Soap-hub-AA/stm32-thermo-clock/hardware/SCH_Schematic1_2026-10-10.pdf

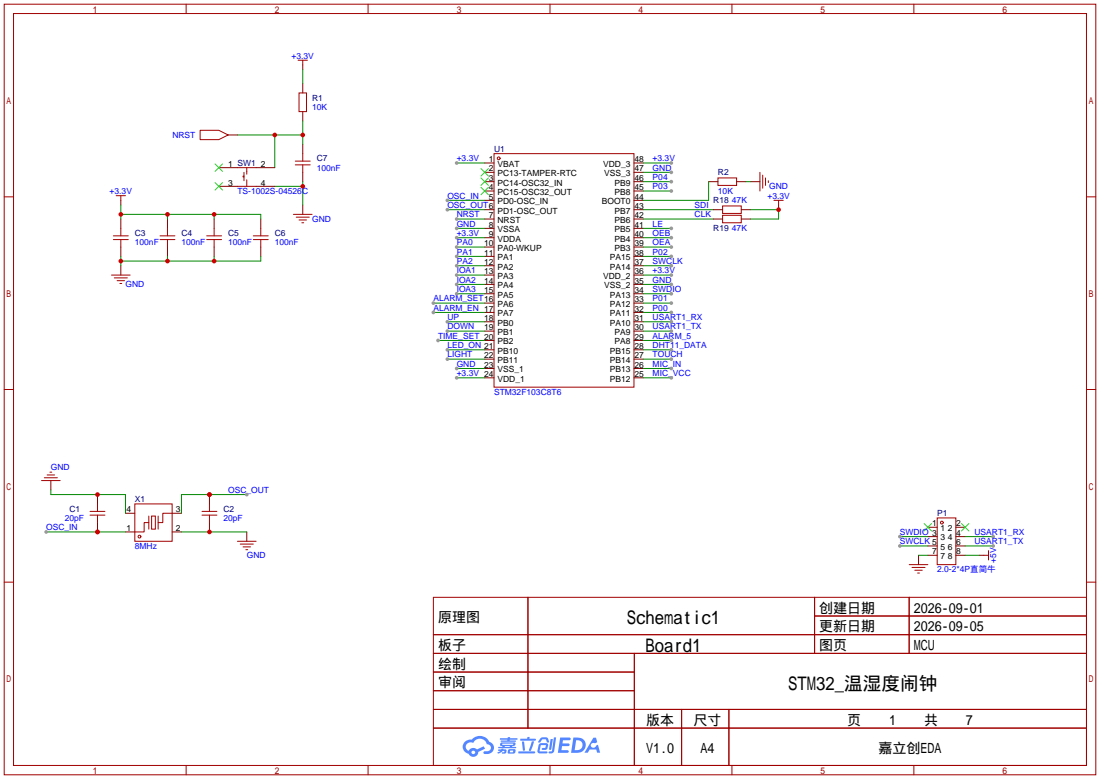
[picture p1: page 1]

原理图 | Schematic1 | 创建日期 | 2026-09-01

更新日期 | 2026-09-05

板子 | Board1 | 图页 | MCU
绘制 | | STM32_温湿度闹钟
审阅

V1.0 | A4 | 嘉立创EDA

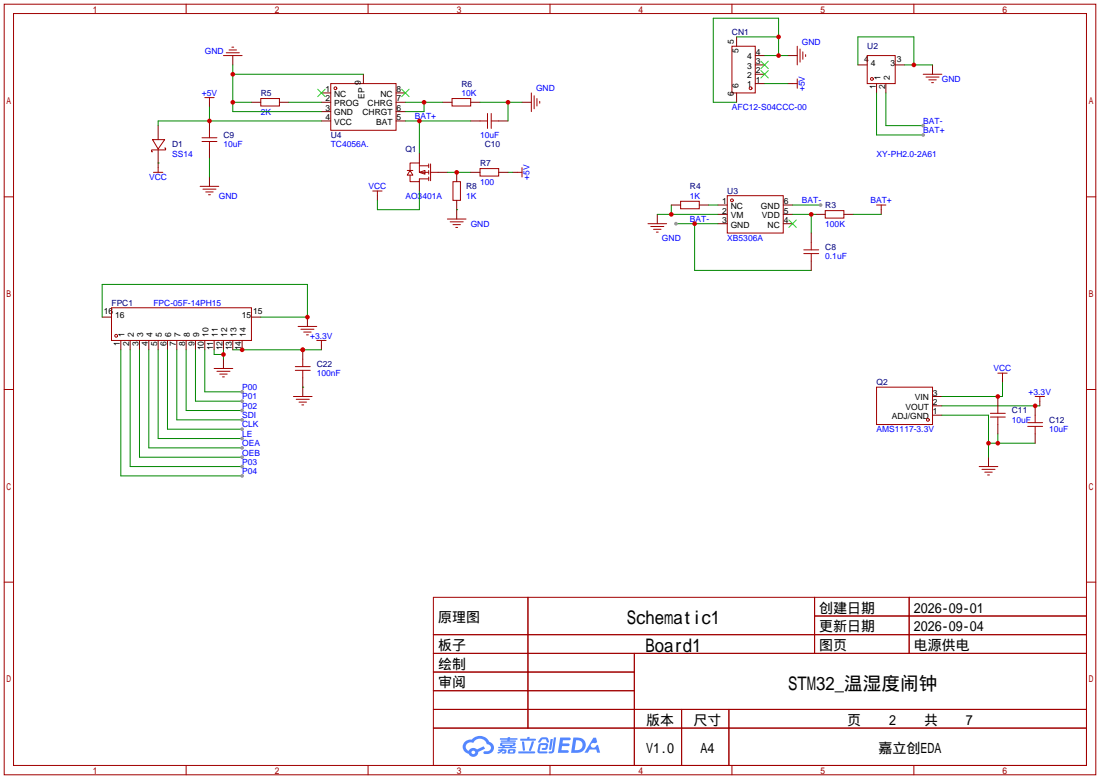
[picture p2: page 2]

原理图 | Schematic1 | 创建日期 | 2026-09-01

更新日期 | 2026-09-04

板子 | Board1 | 图页 | 电源供电
绘制 | | STM32_温湿度闹钟
审阅

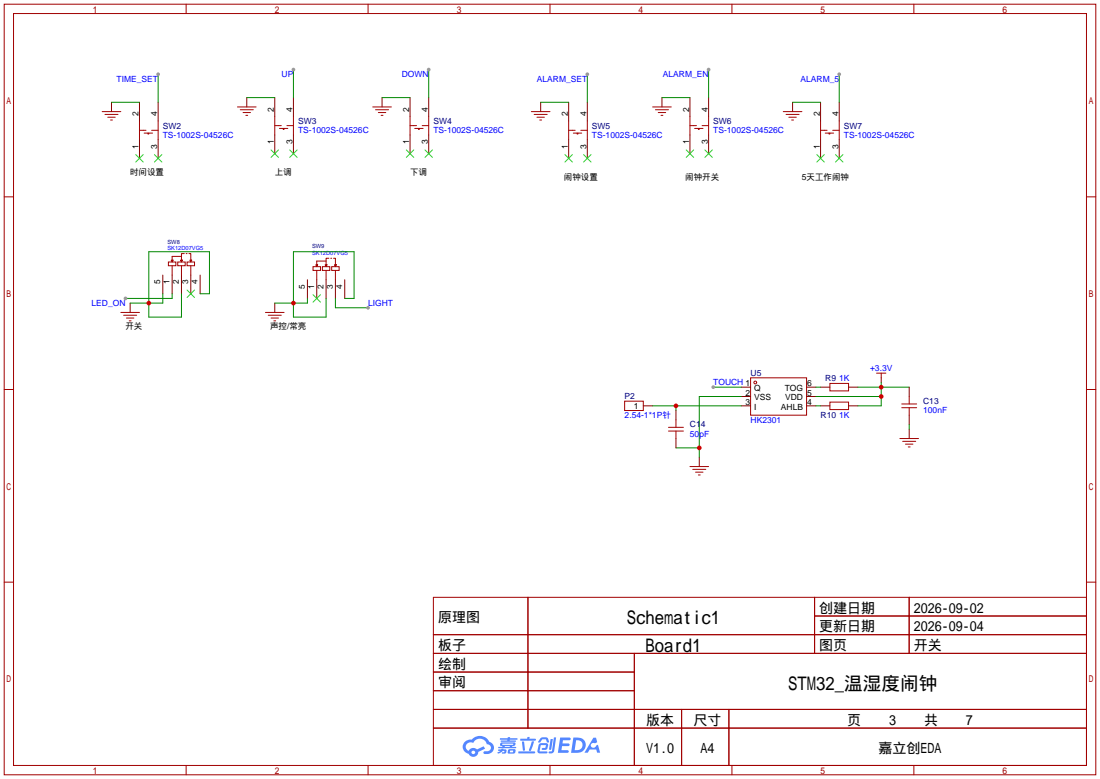
[picture p3: page 3]

原理图 | Schematic1 | 创建日期 | 2026-09-02

更新日期 | 2026-09-04

板子 | Board1 | 图页 | 开关
绘制 | | STM32_温湿度闹钟
审阅

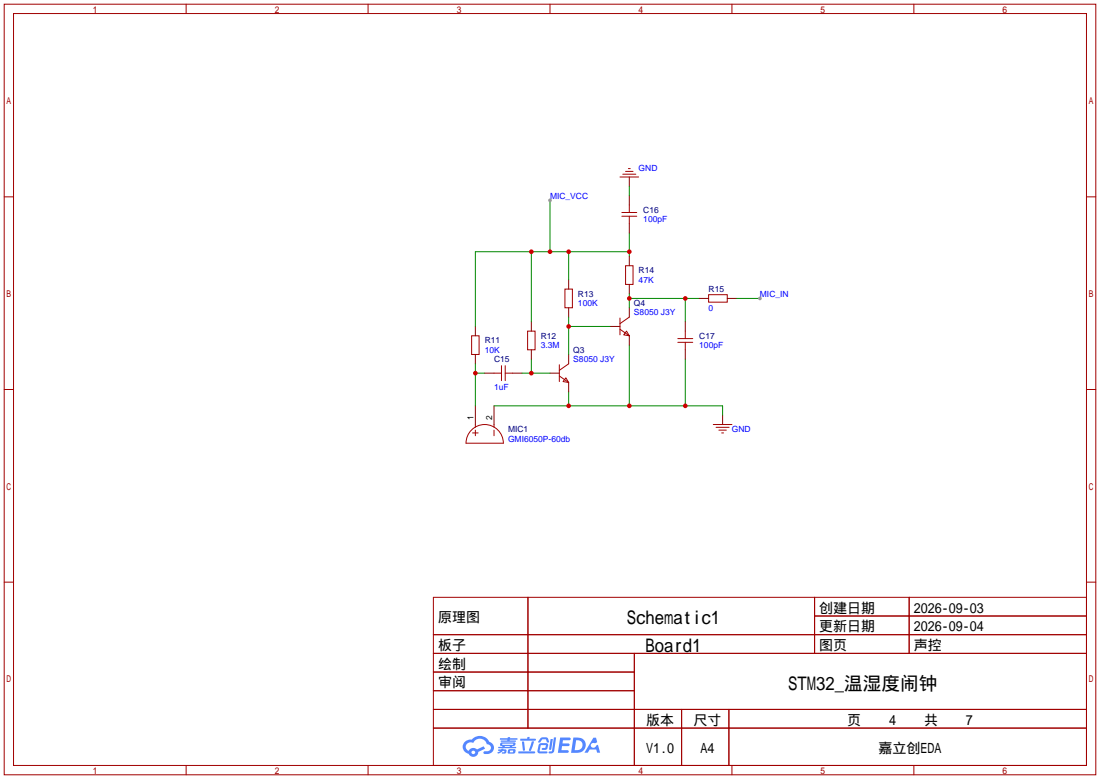
[picture p4: page 4]

原理图 | Schematic1 | 创建日期 | 2026-09-03

更新日期 | 2026-09-04

板子 | Board1 | 图页 | 声控
绘制 | | STM32_温湿度闹钟
审阅

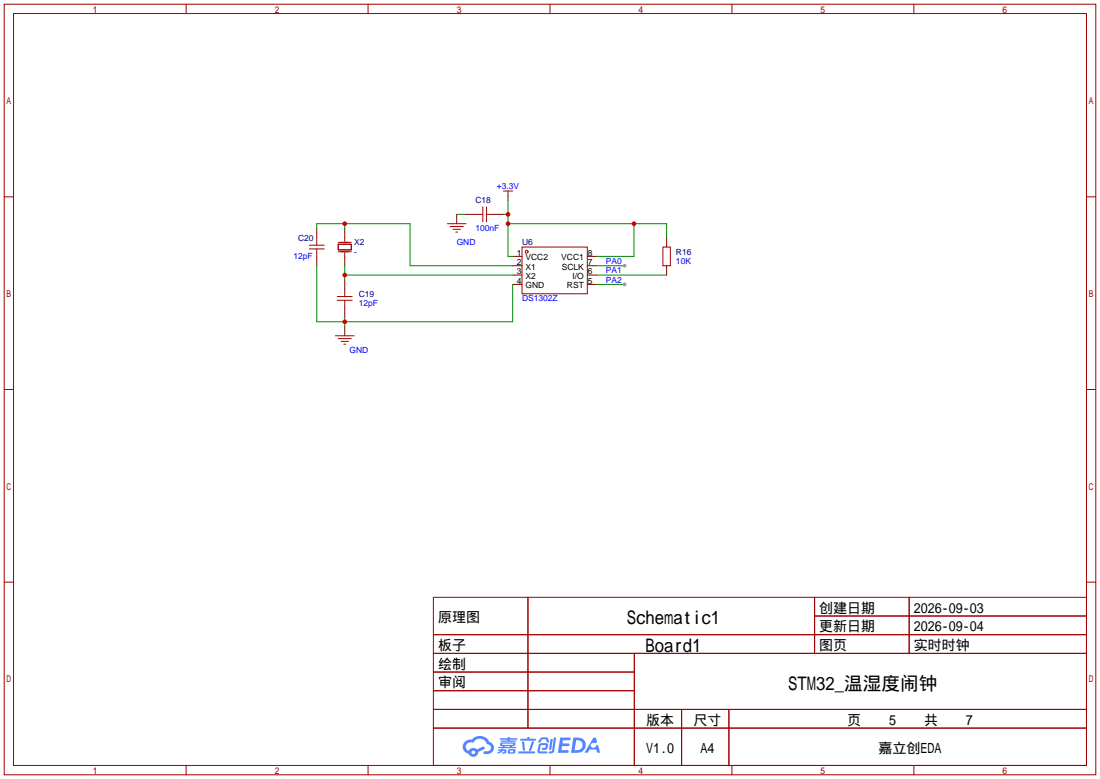
[picture p5: page 5]

原理图 | Schematic1 | 创建日期 | 2026-09-03

更新日期 | 2026-09-04

板子 | Board1 | 图页 | 实时时钟
绘制 | | STM32_温湿度闹钟
审阅

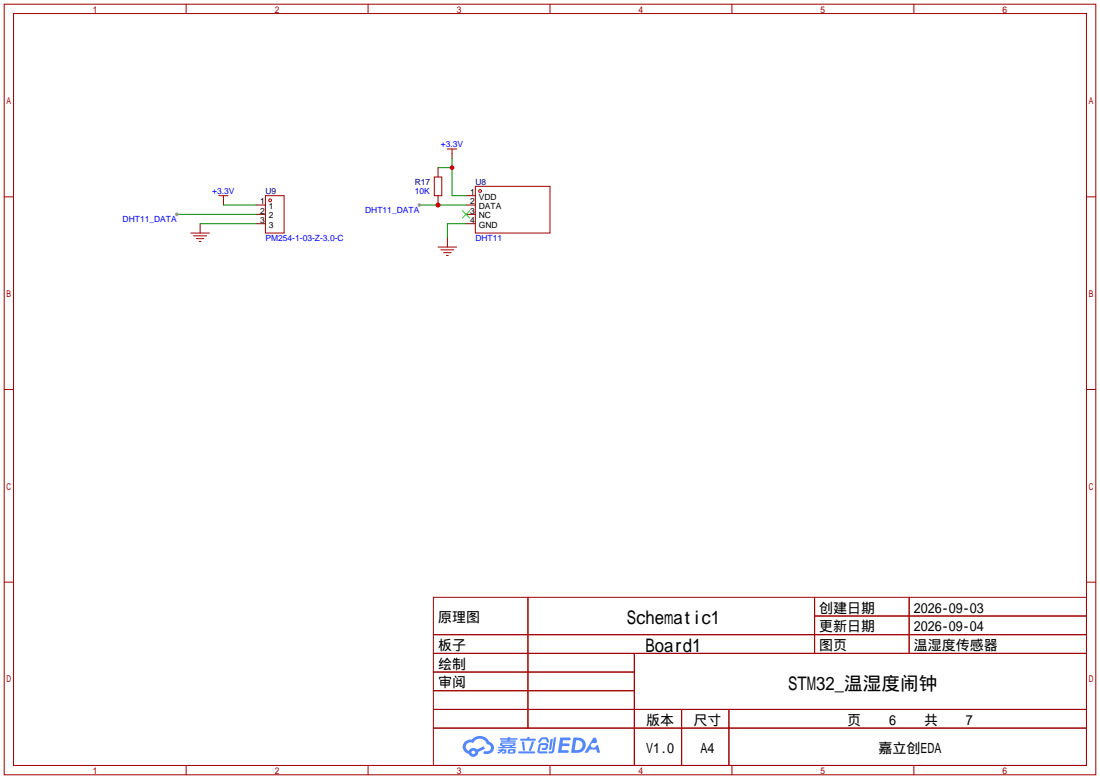
[picture p6: page 6]

原理图 | Schematic1 | 创建日期 | 2026-09-03

更新日期 | 2026-09-04

板子 | Board1 | 图页 | 温湿度传感器
绘制 | | STM32_温湿度闹钟
审阅

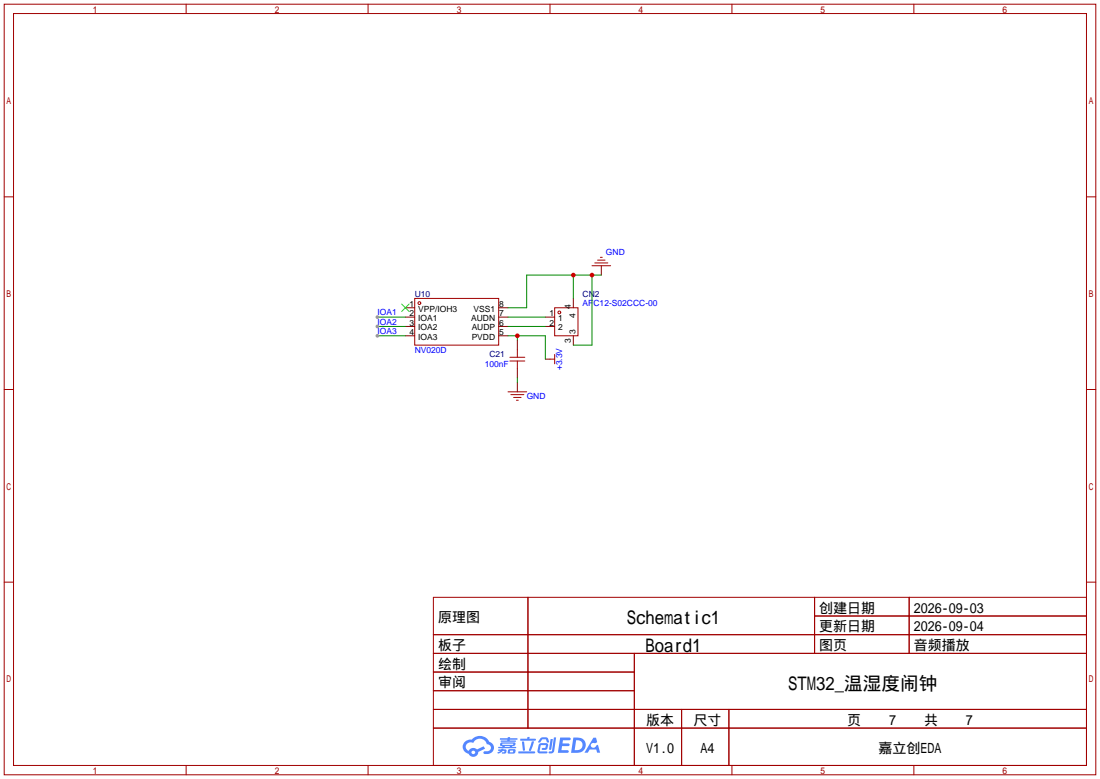
[picture p7: page 7]

原理图 | Schematic1 | 创建日期 | 2026-09-03

更新日期 | 2026-09-04

板子 | Board1 | 图页 | 音频播放
绘制 | | STM32_温湿度闹钟
审阅
