Soap-hub-AA/stm32-thermo-clock/hardware/SCH_Schematic2_2026-10-10.pdf

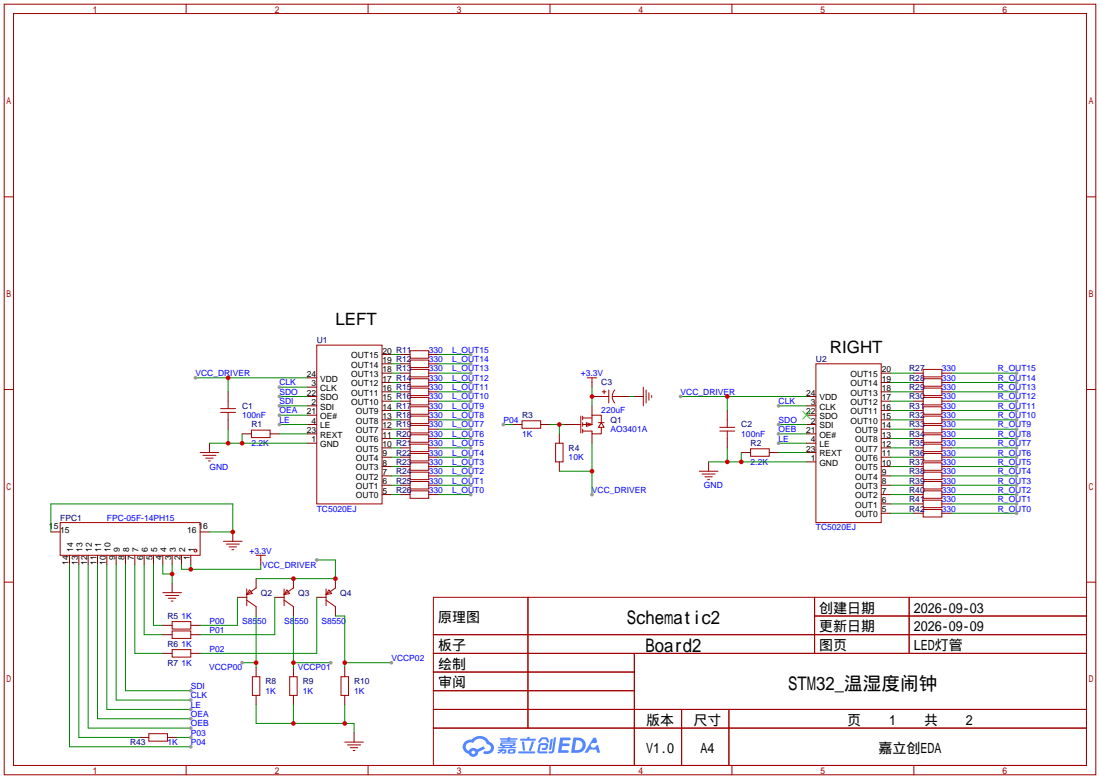
[picture p8: page 1]

原理图 | Schematic2 | 创建日期 | 2026-09-03

更新日期 | 2026-09-09

绘制 | STM32_温湿度闹钟
审阅

V1.0 | A4 | 嘉立创EDA

时钟

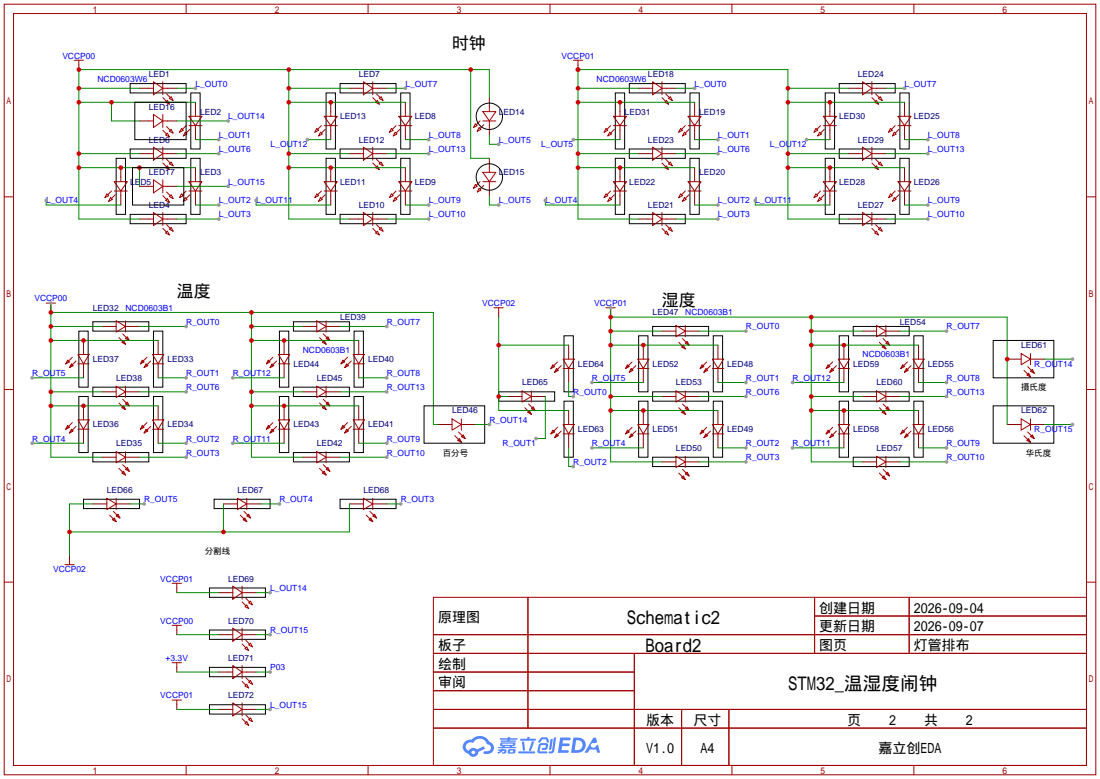
[picture p9: page 2]

LED39

LED54

LED37

原理图 | Schematic2 | 创建日期 | 2026-09-04

更新日期 | 2026-09-07

板子 | Board2 | 图页 | 灯管排布
绘制 | | STM32_温湿度闹钟
审阅

V1.0 | A4 | 嘉立创EDA
