Soap-hub-AA/stm32-thermo-clock/firmware/Core/Src/main.c

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
/* Includes ------------------------------------------------------------------*/
#include "main.h"
#include "usart.h"
#include "gpio.h"

/* USER CODE BEGIN Includes */
#include "com_debug.h"
#include "App_freeRTOS.h"
#include "Inf_DS1302Z.h"
/* USER CODE END Includes */


void SystemClock_Config(void);
/**
  * @brief  The application entry point.
  * @retval int
  */
int main(void)
{

  /* MCU Configuration--------------------------------------------------------*/

  /* Reset of all peripherals, Initializes the Flash interface and the Systick. */
  HAL_Init();

  /* Configure the system clock */
  SystemClock_Config();

  /* Initialize all configured peripherals */
  MX_GPIO_Init();
  MX_USART1_UART_Init();
  /* USER CODE BEGIN 2 */
  //一测试代码三锟斤拷锟斤拷锟斤拷?锟斤拷锟斤拷写锟斤拷锟斤拷??
  //测试代码一
  //HAL_UART_Transmit(&huart1,"hello",5,100);
  debug_printf("h烧录成功");


  //在freeRTOS启动之前 测试一下延时
  Inf_Delay_us(3000000);

  debug_printf("hellow world %d", 10);

  //测试代码二
  App_freeRTOS_start();
  /* USER CODE END 2 */

  /* Infinite loop */
  /* USER CODE BEGIN WHILE */
  while (1)
  {
    /* USER CODE END WHILE */

    /* USER CODE BEGIN 3 */
  }
  /* USER CODE END 3 */
}

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
