Soap-hub-AA/stm32-thermo-clock/firmware/P01_CLOCK_HAL.ioc

Mcu.UserName=STM32F103C8Tx
PA0-WKUP.GPIO_Label=DS_CLK
PA0-WKUP.Signal=GPIO_Output
PA1.GPIO_Label=DS_IO
PA1.Signal=GPIO_Output
PA10.Signal=USART1_RX
PA11.GPIO_Label=VCCP00
PA11.Signal=GPIO_Output
PA12.GPIO_Label=VCCP01
PA12.Signal=GPIO_Output
PA13.Signal=SYS_JTMS-SWDIO
PA14.Signal=SYS_JTCK-SWCLK
PA15.GPIO_Label=VCCP02
PA15.Signal=GPIO_Output
PA2.GPIO_Label=DS_RST
PA2.Signal=GPIO_Output
PA3.GPIO_Label=NVD_BUSY
PA3.Signal=GPIO_Input
PA4.GPIO_Label=NVD_CLK
PA4.Signal=GPIO_Output
PA5.GPIO_Label=NVD_SDA
PA5.Signal=GPIO_Output
PA6.GPIO_Label=ALARM_SET
PA6.Signal=GPIO_Input
PA7.GPIO_Label=ALARM_EN
PA7.Signal=GPIO_Input
PA8.GPIO_Label=ALARM_5
PA8.Signal=GPIO_Input
PA9.Signal=USART1_TX
PB0.GPIO_Label=UP
PB0.Signal=GPIO_Input
PB1.GPIO_Label=DOWN
PB1.Signal=GPIO_Input
PB10.GPIO_Label=LED_ON
PB10.Signal=GPIO_Input
PB11.GPIO_Label=LIGHT
PB11.Signal=GPIO_Input
PB12.GPIO_Label=MIC_VCC
PB12.Signal=GPIO_Output
PB13.GPIO_Label=MIC_IN
PB13.Signal=GPIO_Input
PB14.GPIO_Label=TOUCH
PB14.Signal=GPIO_Input
PB15.GPIO_Label=DHT11_DATA
PB15.Signal=GPIO_Output
PB2.GPIO_Label=TIME_SET
PB2.Signal=GPIO_Input
PB3.GPIO_Label=LED_OEA
PB3.Signal=GPIO_Output
PB4.GPIO_Label=LED_OEB
PB4.Signal=GPIO_Output
PB5.GPIO_Label=LED_LE
PB5.Signal=GPIO_Output
PB6.GPIO_Label=LED_CLK
PB6.Signal=GPIO_Output
PB7.GPIO_Label=LED_SDI
PB7.Signal=GPIO_Output
PB8.GPIO_Label=P03
PB8.Signal=GPIO_Output
PB9.GPIO_Label=P04
PB9.Signal=GPIO_Output
PD0-OSC_IN.Signal=RCC_OSC_IN
PD1-OSC_OUT.Signal=RCC_OSC_OUT
