Soap-hub-AA/stm32-thermo-clock/firmware/MDK-ARM/interface/Inf_mic.c

#include "Inf_mic.h"


/**
 * @brief 根据MIC_IN的值判断是否有人说话
 * 
 * 
 * @return Mic_value 1 表示有人说话 0 表示没有人说话
 */
Mic_value Inf_get_mic_value(void)
{
    //读取值为0的时候 有人大声说话
    //读取值为1的时候 没有人说话
    if (HAL_GPIO_ReadPin(MIC_IN_GPIO_Port, MIC_IN_Pin) == GPIO_PIN_RESET)
    {
        return MIC_ON;
    }

    return MIC_OFF;
}
