Soap-hub-AA/stm32-thermo-clock/firmware/MDK-ARM/interface/Inf_touch.h

#ifndef __INF_TOUCH__
#define __INF_TOUCH__

#include "gpio.h"

typedef enum
{
    TOUCH,
    NO_TOUCH,
}Touch_value;


/**
 * @brief 获取当前触摸开关的值
 * 
 * @return Touch_value
 */

Touch_value Inf_get_touch_value(void);

#endif // __INF_TOUCH__
